crummyh/stem-research-2025-2026/docs/mcu_params.md

# MCU Params

The MCU has a number of prams that can be set using `CMD_SET_PARAM`. They are as follows:

| Name | Hex Code | Type  | Description |
|---|---|---|---|
| `TENDON_MOTOR_SPEED` | `0x00` | int32 | Set the speed of the tendon motors in RPM |
