crummyh/stem-research-2025-2026/circuit_design/stem-research/stem-research.kicad_sch

## KiCad design circuit_design/stem-research/stem-research.kicad_sch (2025-10-24, an earlier design)

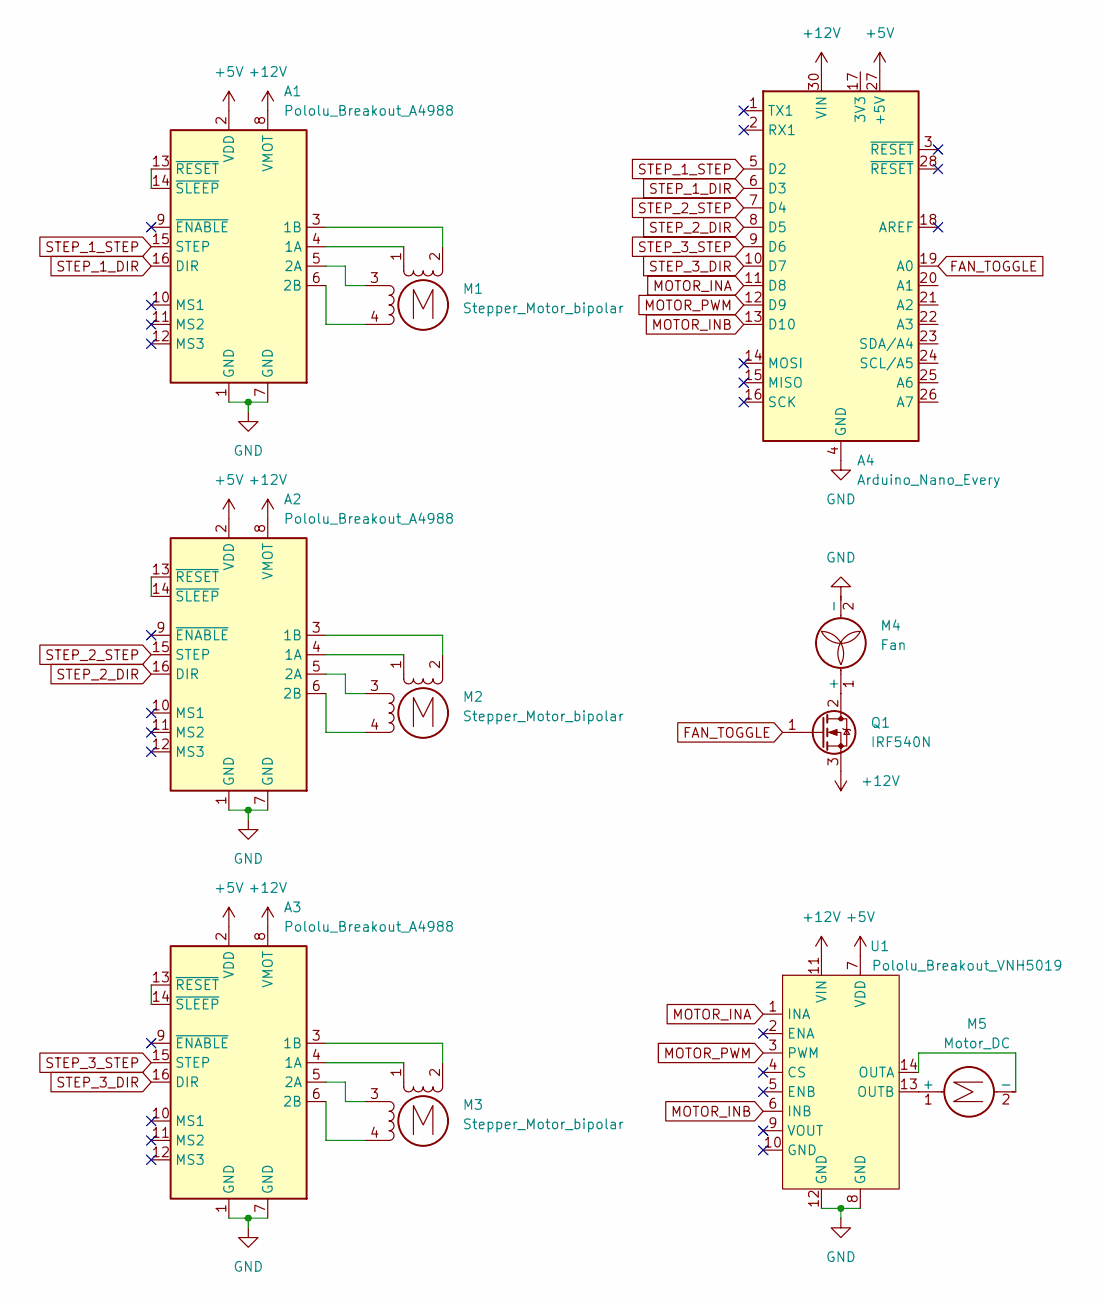
[picture p1: schematic stem-research.kicad_sch]

Parts:
A1, A2, A3: Pololu_Breakout_A4988; Pololu_Breakout-16_15.2x20.3mm
A4: Arduino_Nano_Every; Arduino_Nano
M1, M2, M3: Stepper_Motor_bipolar
M4: Fan
M5: Motor_DC
Q1: IRF540N; TO-220-3_Vertical
U1: Pololu_Breakout_VNH5019

Connections:
+5V: A1.2 (VDD), A2.2 (VDD), A3.2 (VDD), A4.27 (+5V), U1.7 (VDD)
+12V: A1.8 (VMOT), A2.8 (VMOT), A3.8 (VMOT), A4.30 (VIN), Q1.3 (S), U1.11 (VIN)
FAN_TOGGLE: A4.19 (A0), Q1.1 (G)
GND: A1.1 (GND), A1.7 (GND), A2.1 (GND), A2.7 (GND), A3.1 (GND), A3.7 (GND), A4.4 (GND), A4.29 (GND), M4.2 (-), U1.8 (GND), U1.12 (GND)
MOTOR_INA: A4.11 (D8), U1.1 (INA)
MOTOR_INB: A4.13 (D10), U1.6 (INB)
MOTOR_PWM: A4.12 (D9), U1.3 (PWM)
unnamed: A1.3 (1B), M1.2 (-)
unnamed: A1.4 (1A), M1.1
unnamed: A1.5 (2A), M1.3
unnamed: A1.6 (2B), M1.4
unnamed: A1.13 (~RESET), A1.14 (~SLEEP)
unnamed: A2.3 (1B), M2.2 (-)
unnamed: A2.4 (1A), M2.1
unnamed: A2.5 (2A), M2.3
unnamed: A2.6 (2B), M2.4
unnamed: A2.13 (~RESET), A2.14 (~SLEEP)
unnamed: A3.3 (1B), M3.2 (-)
unnamed: A3.4 (1A), M3.1
unnamed: A3.5 (2A), M3.3
unnamed: A3.6 (2B), M3.4
unnamed: A3.13 (~RESET), A3.14 (~SLEEP)
unnamed: M4.1 (+), Q1.2 (D)
unnamed: M5.1 (+), U1.13 (OUTB)
unnamed: M5.2 (-), U1.14 (OUTA)
STEP_1_DIR: A1.16 (DIR), A4.6 (D3)
STEP_1_STEP: A1.15 (STEP), A4.5 (D2)
STEP_2_DIR: A2.16 (DIR), A4.8 (D5)
STEP_2_STEP: A2.15 (STEP), A4.7 (D4)
STEP_3_DIR: A3.16 (DIR), A4.10 (D7)
STEP_3_STEP: A3.15 (STEP), A4.9 (D6)
