crummyh/stem-research-2025-2026/test_logs/jan_8_13-18.md

# Test Run
January 8, 13:18

## Goal
Verify system works when mounted

## Procedure
Connect everything, attempt to move to various positions. Make sure that the right motors spin, and in the right direction.

## Results/Findings
Everything works, except the motor bindings were slightly wrong. This was fixed in the same commit.

## Related Files
None
