crummyh/stem-research-2025-2026/test_logs/jan_3_17-10.md

# Test Run
January 3, 17:10

## Goal

Verify tendon positioning works and errors are not thrown when staying on the same value

## Procedure

Connect everything, set speed to medium. Attempt to move body to various positions, and check motor output.

## Results/Findings

The tendon set points are *much* higher then the should be, rotating ~12 times when they are supposed to only rotate ~0.5 times.

## Related Files
None
