crummyh/stem-research-2025-2026/test_logs/jan_3_16-18.md

# Test Run
January 3, 16:18

## Goal

Verify tendon speed param

## Procedure

Connect everything, set speed to various levels and make sure the param is set. Attempt to move body to various positions, and check motor output.

## Results/Findings

The speed setting works, but the motor positioning does not. They keep going without stopping at the correct point, and send nack 00 messages when going sideways for seemingly no reason.

## Related Files
None
