crummyh/stem-research-2025-2026/test_logs/jan_3_15-26.md

# Test Run
January 3, 15:26

## Goal

To verify the electrical system and motor control logic

## Procedure

Connect everything, move spool motor and move tendons. (Add more info here)

## Results/Findings

Tendon motor speeds are way too low, they need to be set with a slider similar to the main spool motor.

## Related Files
None
