crummyh/stem-research-2025-2026/test_logs/_BASE_FORMAT.md

# Test Run
Date, Time

## Goal

## Procedure

## Results/Findings

## Related Files
