crummyh/stem-research-2025-2026/(commit log)

2025-10-16 Add arduino sketch
2025-10-21 Add basic supervisor setup and ECAD
    [stem-research.kicad_pcb, stem-research.kicad_sch]
2025-10-22 Replace spool motor with stepper
2025-10-24 Replace Stepper Controlers and Switch to 24V
    [stem-research.kicad_sch]
2025-10-30 Update arduino setup
2025-11-10 Add controller connection and arduino communication
2025-12-30 I would write a real message but I did too much
    [PacketProtocol.cpp, PacketProtocol.h, PositionStepper.cpp, PositionStepper.h, executor.ino]
2026-01-02 Rework speed based stepper control to match the new position based control
    [ContinuousStepper.cpp, ContinuousStepper.h]
2026-01-03 Add all 4 motors
2026-01-03 Add param for tendon motor speed
2026-01-03 Fix off by one error when reaching position
    [PositionStepper.cpp]
2026-01-04 Create test 4 and fix assosiated error
    [executor.ino]
2026-01-04 Remove outputs from tendons.ipynb
2026-02-08 Add mounting test and fix motor binding
    [executor.ino]
